laszloh/esp8266-temperature/Housing/assembly.FCStd

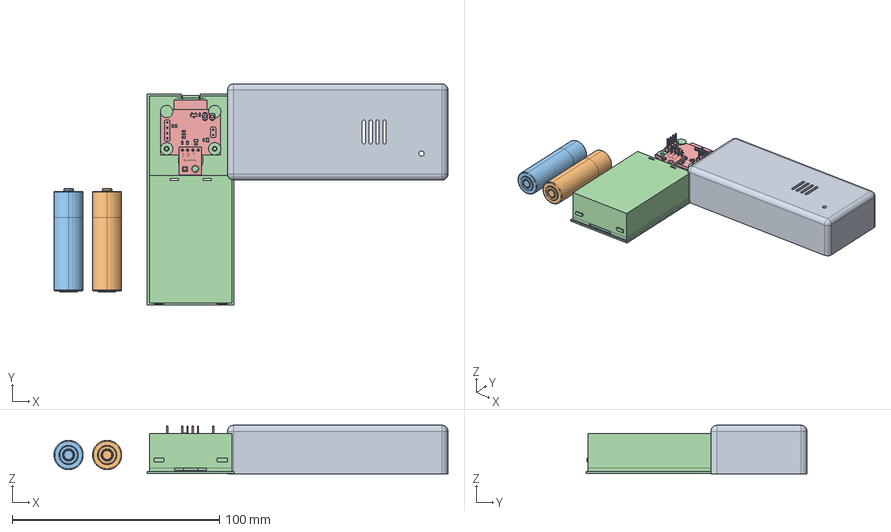
[picture p1: CAD file, 2020-10-11]
Housing/assembly.FCStd
190.3 x 106.9 x 23.5 mm
top_001
bat-AA-LR61_001
bat-AA-LR61_002
bottom_v2_bottom_001
pcb1_001
