laszloh/esp8266-temperature/Housing/parts/bat-AA-LR6.STEP

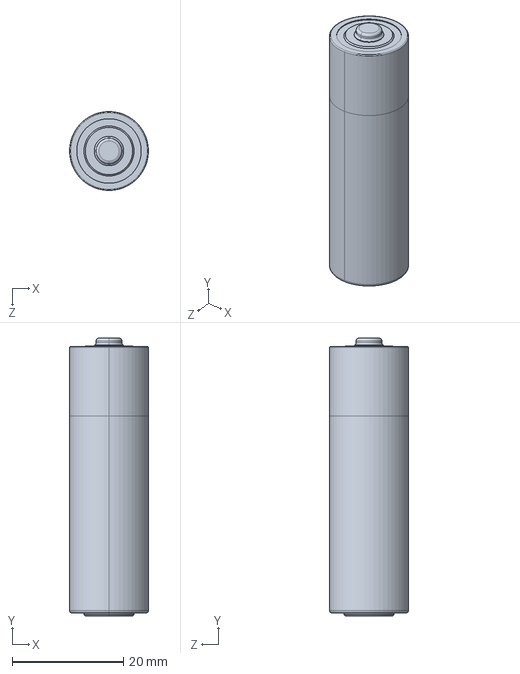
[picture p2: CAD file, 2020-09-14]
Housing/parts/bat-AA-LR6.STEP
14.2 x 50.0 x 14.2 mm
