laszloh/esp8266-temperature/Housing/top.FCStd

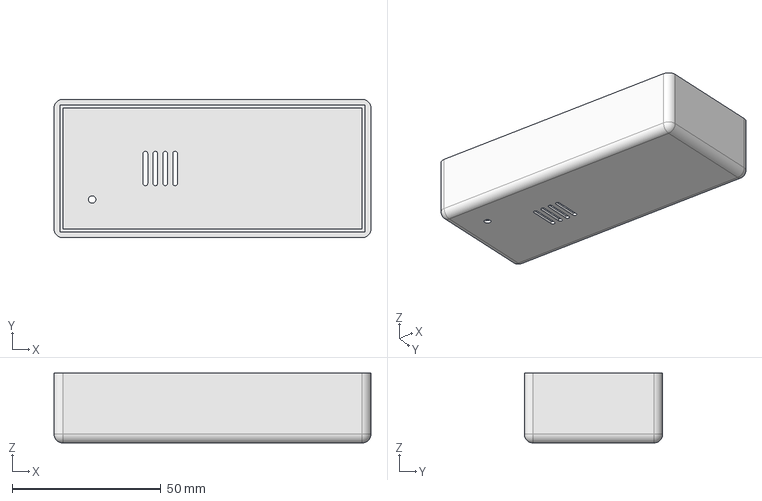
[picture p3: CAD file, 2020-10-13]
Housing/top.FCStd
106.5 x 46.5 x 23.5 mm
