laszloh/esp8266-temperature/Housing/bottom_v2.FCStd

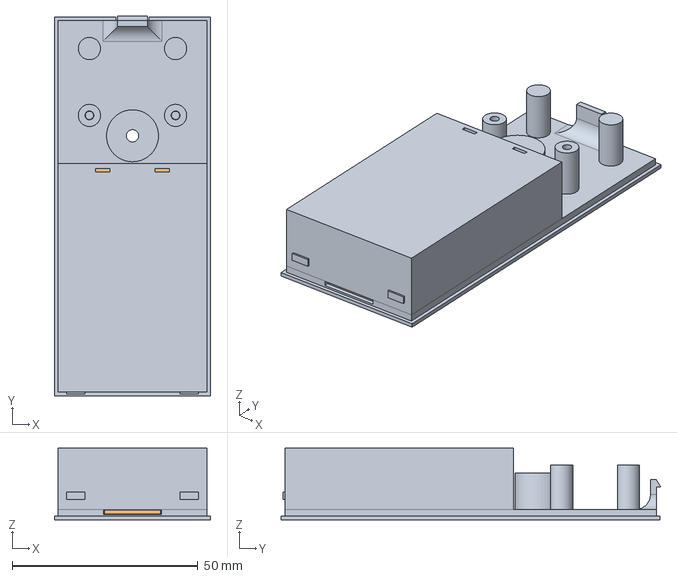
[picture p4: CAD file, 2020-10-13]
Housing/bottom_v2.FCStd
42.0 x 102.2 x 19.3 mm
bottom
cover
