laszloh/esp8266-temperature/PCB/esp8266-battery/esp8266-battery.kicad_pcb

## KiCad design PCB/esp8266-battery/esp8266-battery.kicad_pcb (2020-10-31)

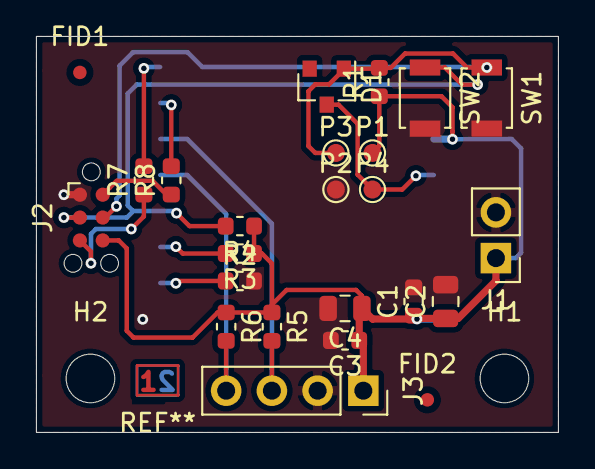
[picture p5: board esp8266-battery.kicad_pcb from above]

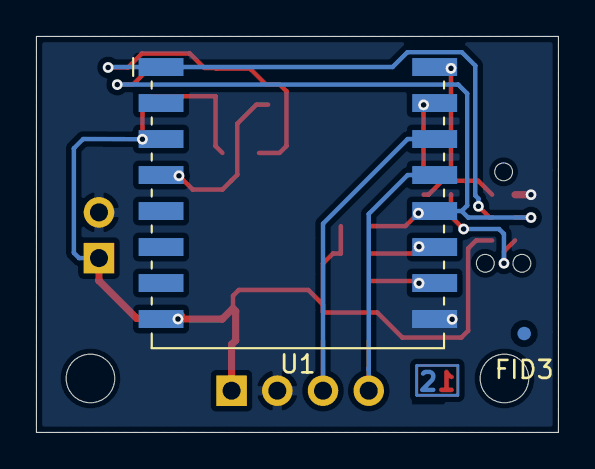
[picture p6: board esp8266-battery.kicad_pcb from below]

Board: 2 copper layers, 29.0 x 22.0 mm, 28 parts (2 on the bottom side), 13 nets.

Parts:
C1, C3: 100n; C_0603_1608Metric
C2, C4: 10u; C_0805_2012Metric
D1: BAT-85; D_SOT-23_ANK
FID1, FID2, FID3: Fiducial; Fiducial_0.75mm_Mask1.5mm
H1, H2: MountingHole_Pad; MountingHole_2.7mm_M2.5
J1: 2xAA; PinHeader_1x02_P2.54mm_Vertical
J2: program; Tag-Connect_TC2030-IDC-NL_2x03_P1.27mm_Vertical
J3: BME280 modul; PinSocket_1x04_P2.54mm_Vertical
P1, P2, P3, P4: ICT-Point; TestPoint_Pad_D1.0mm
R1, R2, R3, R4: 10k; R_0603_1608Metric
R5, R6: 1.5k; R_0603_1608Metric
R7, R8: 220R; R_0603_1608Metric
SW1: reset; SW_SPST_B3U-1000P
SW2: boot; SW_SPST_B3U-1000P
U1: ESP-07

Connections:
+3V3: C1.1, C2.1, C3.1, C4.1, J1.1, J2.6, J3.1, P1.1, R1.1, R3.1, R4.1, R5.1, R6.1, U1.3, U1.8
/I2C-SCL: J3.3, R5.2, U1.14
/I2C-SDA: J3.4, R6.2, U1.13
/IO0: J2.3, R4.2, SW2.1, U1.12
/RXD: J2.5, R7.1
/TXD: J2.2, R8.1
/~RST: D1.2, J2.4, P3.1, R1.2, SW1.1, U1.1
GND: C1.2, C2.2, C3.2, C4.2, J1.2, J2.1, J3.2, P2.1, R2.2, SW1.2, SW2.2, U1.9
unnamed: D1.1, P4.1, U1.4
unnamed: R2.1, U1.10
unnamed: R3.2, U1.11
unnamed: R7.2, U1.16
unnamed: R8.2, U1.15
