laszloh/esp8266-temperature/(commit log)

2020-09-13 Add ignore files for KiCAD, FrreCAD and LTSpice
2020-09-13 Add schematic and PCB for battery nodes
    Added the schematic and PCB for the battery driven nodes using an ESP-07
    and BME280
    [esp8266-battery.kicad_pcb, esp8266-battery.sch]
2020-09-13 Add Software framework
    Add the first Software design. This is as of now untested.
2020-09-14 Update layout to final version
    [esp8266-battery.kicad_pcb, esp8266-battery.sch]
2020-09-14 Add missing 3D models
    [esp8266-battery.kicad_pcb]
2020-09-14 Prepare for Housing desing
    [bat-AA-LR6.STEP]
2020-09-15 Design bottom housing part with battery compartment
    [bottom.FCStd, esp8266-battery.kicad_pcb]
2020-09-16 Add housing parts and assembly
    Create the top and bottom shell and add an assembly for the two parts with the batteries and the PCB.
    [assembly.FCStd, bottom.FCStd, top.FCStd]
2020-09-29 squash me if you can
    [Bottom.FCStd]
2020-10-02 Software work
    [bottom.FCStd]
2020-10-03 software finished
    [top.FCStd]
2020-10-09 Add BMP180 sensor support
2020-10-11 add update to wifimanager
    add update to wifimanager and tripple-reset for enter setup
    [assembly.FCStd, bottom_v2.FCStd, top.FCStd]
2020-10-11 squash candidate
    [bottom_v2.FCStd, top.FCStd]
2020-10-12 squash me
    [Bottom.FCStd, bottom.FCStd, bottom.step, bottom_v2.FCStd, top.FCStd]
2020-10-13 fixes needed
    [Bottom.FCStd, bottom.FCStd]
2020-10-23 Cleanup and fix in comment section
    [main.cpp, main.h, mqtt_client.cpp, mqtt_client.h, rtc.cpp, rtc.h, settings.cpp, settings.h]
2020-10-31 Change the debug connector to TC2030-6
    [esp8266-battery.kicad_pcb, esp8266-battery.sch]
